Stenkelfled/B.cool/elektronik/bierkasten.brd

## EAGLE design elektronik/bierkasten.brd (2019-09-13)

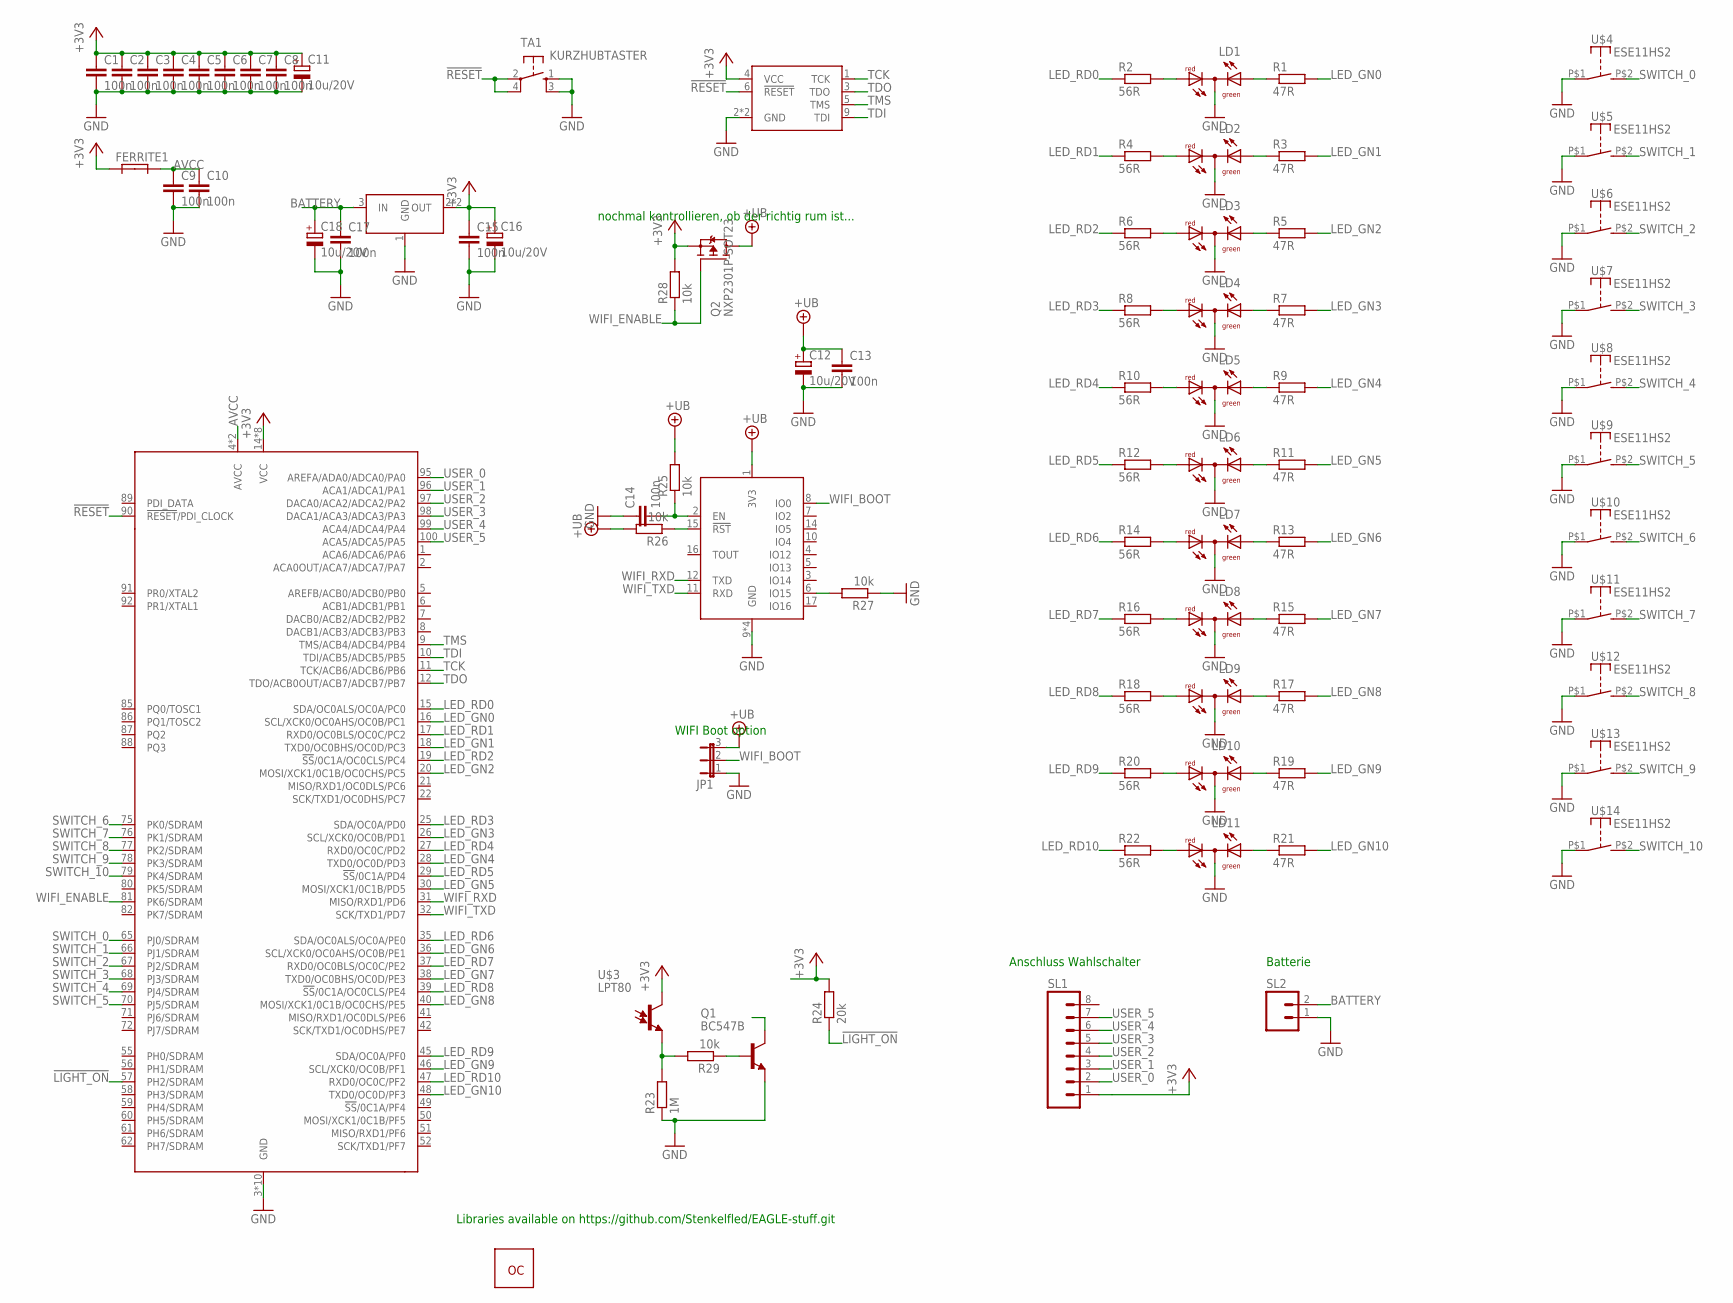
[picture p1: schematic bierkasten.sch]

Parts:
C1, C2, C3, C4, C5, C6, C7, C8, C9, C10, C13, C14, C15, C17: 100n; C0603; FARNELL 432210
C11, C12, C16, C18: 10u/20V; B/3528-21W
FERRITE1: FERRITE-EU_0805; L0805
JP1: JP2E; JP2
LD1, LD2, LD3, LD4, LD5, LD6, LD7, LD8, LD9, LD10, LD11: DUOLED-RG-C-WIRE; DUOLED-C-WIRE
Q1: BC547B; TO92
Q2: NXP2301P-SOT23; SOT23
R1, R3, R5, R7, R9, R11, R13, R15, R17, R19, R21: 47R; R0603; FARNELL 2502461
R2, R4, R6, R8, R10, R12, R14, R16, R18, R20, R22: 56R; R0603
R23: 1M; R0603
R24: 20k; R0603
R25, R26, R27, R28: 10k; R0603; FARNELL 2502397
R29: 10k; R0603
SL1: M08; 08P
SL2: M02; 02P
TA1: KURZHUBTASTER; TA93XX; FARNELL 2292960
U$1: ATXMEGA_A1; TQFP100
U$2: AVR-JTAG-10; WANNE10G
U$3: LPT80
U$4, U$5, U$6, U$7, U$8, U$9, U$10, U$11, U$12, U$13, U$14: ESE11HS2; 2X2,54
U$15: ESP8266-POLLIN
U$16: NCP1117ST33T3G; SOT223
U$17: BESTELLTEILE

Connections:
!LIGHT_ON: R24.1, U$1.57 (PH2/SDRAM)
!RESET: TA1.2, TA1.4 (P1), U$1.90 (!RESET!/PDI_CLOCK), U$2.6 (!RESET)
+3V3: C1.1, C2.1, C3.1, C4.1, C5.1, C6.1, C7.1, C8.1, C11.+, C15.1, C16.+, FERRITE1.1, Q2.2 (S), R24.2, R28.2, SL1.1, U$1.14 (VCC), U$1.24 (VCC), U$1.34 (VCC), U$1.44 (VCC), U$1.54 (VCC), U$1.64 (VCC), U$1.74 (VCC), U$1.83 (VCC), U$2.4 (VCC), U$3.C, U$16.2 (OUT), U$16.4 (OUT)
+UB: C12.+, C13.1, JP1.3, Q2.3 (D), R25.2, R26.2, U$15.1 (3V3)
AVCC: C9.1, C10.1, FERRITE1.2, U$1.4 (AVCC), U$1.94 (AVCC)
BATTERY: C17.1, C18.+, SL2.2, U$16.3 (IN)
GND: C1.2, C2.2, C3.2, C4.2, C5.2, C6.2, C7.2, C8.2, C9.2, C10.2, C11.-, C12.-, C13.2, C14.1, C15.2, C16.-, C17.2, C18.-, JP1.1, LD1.C, LD2.C, LD3.C, LD4.C, LD5.C, LD6.C, LD7.C, LD8.C, LD9.C, LD10.C, LD11.C, Q1.1 (E), R23.1, R27.1, SL2.1, TA1.1 (S), TA1.3 (S1), U$1.3 (GND), U$1.13 (GND), U$1.23 (GND), U$1.33 (GND), U$1.43 (GND), U$1.53 (GND), U$1.63 (GND), U$1.73 (GND), U$1.84 (GND), U$1.93 (GND), U$2.2 (GND), U$2.10 (GND), U$4.P$1, U$5.P$1, U$6.P$1, U$7.P$1, U$8.P$1, U$9.P$1, U$10.P$1, U$11.P$1, U$12.P$1, U$13.P$1, U$14.P$1, U$15.9 (GND), U$15.13 (GND), U$15.18 (GND), U$15.19 (GND), U$16.1 (GND)
LED_GN0: R1.2, U$1.16 (SCL/XCK0/OC0AHS/OC0B/PC1)
LED_GN1: R3.2, U$1.18 (TXD0/OC0BHS/OC0D/PC3)
LED_GN2: R5.2, U$1.20 (MOSI/XCK1/0C1B/OC0CHS/PC5)
LED_GN3: R7.2, U$1.26 (SCL/XCK0/OC0B/PD1)
LED_GN4: R9.2, U$1.28 (TXD0/OC0D/PD3)
LED_GN5: R11.2, U$1.30 (MOSI/XCK1/0C1B/PD5)
LED_GN6: R13.2, U$1.36 (SCL/XCK0/OC0AHS/OC0B/PE1)
LED_GN7: R15.2, U$1.38 (TXD0/OC0BHS/OC0D/PE3)
LED_GN8: R17.2, U$1.40 (MOSI/XCK1/0C1B/OC0CHS/PE5)
LED_GN9: R19.2, U$1.46 (SCL/XCK0/OC0B/PF1)
LED_GN10: R21.2, U$1.48 (TXD0/OC0D/PF3)
LED_RD0: R2.1, U$1.15 (SDA/OC0ALS/OC0A/PC0)
LED_RD1: R4.1, U$1.17 (RXD0/OC0BLS/OC0C/PC2)
LED_RD2: R6.1, U$1.19 (!SS!/0C1A/OC0CLS/PC4)
LED_RD3: R8.1, U$1.25 (SDA/OC0A/PD0)
LED_RD4: R10.1, U$1.27 (RXD0/OC0C/PD2)
LED_RD5: R12.1, U$1.29 (!SS!/0C1A/PD4)
LED_RD6: R14.1, U$1.35 (SDA/OC0ALS/OC0A/PE0)
LED_RD7: R16.1, U$1.37 (RXD0/OC0BLS/OC0C/PE2)
LED_RD8: R18.1, U$1.39 (!SS!/0C1A/OC0CLS/PE4)
LED_RD9: R20.1, U$1.45 (SDA/OC0A/PF0)
LED_RD10: R22.1, U$1.47 (RXD0/OC0C/PF2)
unnamed: LD1.AR, R2.2
unnamed: LD1.AX (AG), R1.1
unnamed: LD2.AR, R4.2
unnamed: LD2.AX (AG), R3.1
unnamed: LD3.AR, R6.2
unnamed: LD3.AX (AG), R5.1
unnamed: LD4.AR, R8.2
unnamed: LD4.AX (AG), R7.1
unnamed: LD5.AR, R10.2
unnamed: LD5.AX (AG), R9.1
unnamed: LD6.AR, R12.2
unnamed: LD6.AX (AG), R11.1
unnamed: LD7.AR, R14.2
unnamed: LD7.AX (AG), R13.1
unnamed: LD8.AR, R16.2
unnamed: LD8.AX (AG), R15.1
unnamed: LD9.AR, R18.2
unnamed: LD9.AX (AG), R17.1
unnamed: LD10.AR, R20.2
unnamed: LD10.AX (AG), R19.1
unnamed: LD11.AR, R22.2
unnamed: LD11.AX (AG), R21.1
unnamed: R23.2, R29.2, U$3.E
unnamed: C14.2, R25.1, U$15.2 (EN)
unnamed: R27.2, U$15.6 (IO15)
unnamed: R26.1, U$15.15 (!RST)
unnamed: Q1.2 (B), R29.1
SWITCH_0: U$1.65 (PJ0/SDRAM), U$4.P$2 (S)
SWITCH_1: U$1.66 (PJ1/SDRAM), U$5.P$2 (S)
SWITCH_2: U$1.67 (PJ2/SDRAM), U$6.P$2 (S)
SWITCH_3: U$1.68 (PJ3/SDRAM), U$7.P$2 (S)
SWITCH_4: U$1.69 (PJ4/SDRAM), U$8.P$2 (S)
SWITCH_5: U$1.70 (PJ5/SDRAM), U$9.P$2 (S)
SWITCH_6: U$1.75 (PK0/SDRAM), U$10.P$2 (S)
SWITCH_7: U$1.76 (PK1/SDRAM), U$11.P$2 (S)
SWITCH_8: U$1.77 (PK2/SDRAM), U$12.P$2 (S)
SWITCH_9: U$1.78 (PK3/SDRAM), U$13.P$2 (S)
SWITCH_10: U$1.79 (PK4/SDRAM), U$14.P$2 (S)
TCK: U$1.11 (TCK/ACB6/ADCB6/PB6), U$2.1 (TCK)
TDI: U$1.10 (TDI/ACB5/ADCB5/PB5), U$2.9 (TDI)
TDO: U$1.12 (TDO/ACB0OUT/ACB7/ADCB7/PB7), U$2.3 (TDO)
TMS: U$1.9 (TMS/ACB4/ADCB4/PB4), U$2.5 (TMS)
USER_0: SL1.2, U$1.95 (AREFA/ADA0/ADCA0/PA0)
USER_1: SL1.3, U$1.96 (ACA1/ADCA1/PA1)
USER_2: SL1.4, U$1.97 (DACA0/ACA2/ADCA2/PA2)
USER_3: SL1.5, U$1.98 (DACA1/ACA3/ADCA3/PA3)
USER_4: SL1.6, U$1.99 (ACA4/ADCA4/PA4)
USER_5: SL1.7, U$1.100 (ACA5/ADCA5/PA5)
WIFI_BOOT: JP1.2, U$15.8 (IO0)
WIFI_ENABLE: Q2.1 (G), R28.1, U$1.81 (PK6/SDRAM)
WIFI_RXD: U$1.31 (MISO/RXD1/PD6), U$15.12 (TXD)
WIFI_TXD: U$1.32 (SCK/TXD1/PD7), U$15.11 (RXD)

Notes on the sheet:
Libraries available on https://github.com/Stenkelfled/EAGLE-stuff.git
WIFI Boot option
Anschluss Wahlschalter
nochmal kontrollieren, ob der richtig rum ist...
Batterie

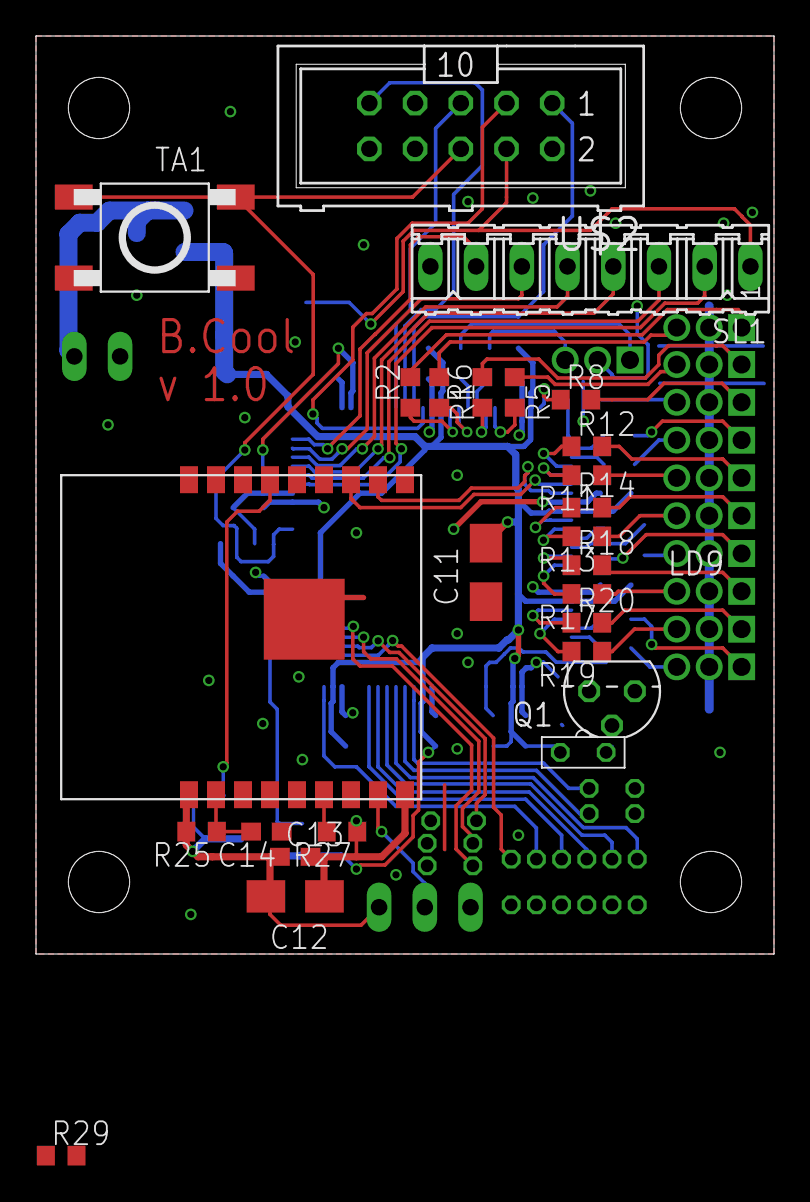
[picture p2: board bierkasten.brd from above]

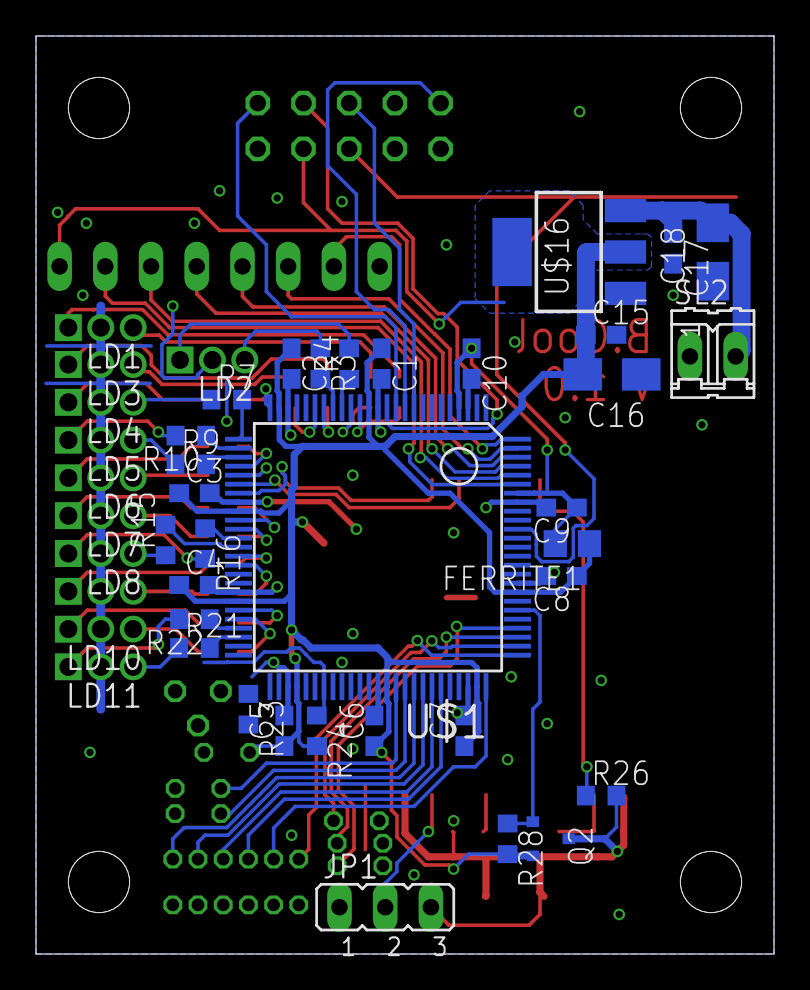
[picture p3: board bierkasten.brd from below]

Board: 2 copper layers, 41.0 x 51.0 mm, 82 parts (55 on the bottom side), 81 nets.
