Stenkelfled/B.cool/firmware/BeerSlot.cpp

/* 
* BeerSlot.cpp
*
* Created: 28.10.2018 11:48:47
* Author: stenkelfled
*/


#include "BeerSlot.h"

/**
 * @brief Creates a new Beer Slot.
 * For correct functionality, please initialize this slot after calling the constructor!
 * (functions setup(__), pinInit(__), ledInit(__)
 */
BeerSlot::BeerSlot()//BeerTimer * timer)
{
  this->sSwitch.state = eState::empty;
  this->user = USER_NOUSER;
} //BeerSlot

// default destructor
BeerSlot::~BeerSlot()
{
} //~BeerSlot

void BeerSlot::setup(BeerTimer * timer)
{
  this->timer = timer;
}

/**
 * @brief Initialize beer slot
 * @param switch_port The port-adress for the switch. Use e.g. &PORTA
 * @param switch_pin The pin number.
 */
void BeerSlot::pinInit(PORT_t * const switch_port, uint8_t const switch_pin)
{
  this->fill_time = (uint32_t)0;
  
  this->sSwitch.port = switch_port;
  this->sSwitch.pin = switch_pin;
    
  // init switch pin
  this->sSwitch.port->DIRCLR = (1<<this->sSwitch.pin);
  
  //Pullup and Interrupt on both edges
  *(&this->sSwitch.port->PIN0CTRL + this->sSwitch.pin) = PORT_OPC_PULLUP_gc | PORT_ISC_BOTHEDGES_gc;
    
  //set interrupts
  this->sSwitch.port->INTCTRL = PORT_INT0LVL_LO_gc;
  this->sSwitch.port->INT0MASK |= (1<<this->sSwitch.pin);

}

/**
 * @brief Set timer compare registers for LEDs
 * @param red Timer-Compare register for red LED
 * @param green Timer-Compare register for green LED
 */
void BeerSlot::ledInit(register16_t *red, register16_t *green)
{
  this->sLed.red = red;
  this->sLed.green = green;
  
  *this->sLed.red = 0;
  *this->sLed.green = 0;
}

/**
 * @brief Set BeerSlotLed-Color
 */
void BeerSlot::ledSetColor(BeerSlot::eLedColor const color)
{
  switch (color)
  {
    case eLedColor::Off:
      *this->sLed.red = 0;
      *this->sLed.green = 0;
      break;
    case eLedColor::Red:
      *this->sLed.red = LED_ON_VALUE;
      *this->sLed.green = 0;
      break;
    case eLedColor::Green:
      *this->sLed.red = 0;
      *this->sLed.green = LED_ON_VALUE;
      break;
    case eLedColor::Yellow:
      *this->sLed.red = LED_ON_VALUE;
      *this->sLed.green = LED_ON_VALUE;
      break;
  }
}

void BeerSlot::update(user_t user_state)
{
  eState const new_state = (this->sSwitch.port->IN & (1<<this->sSwitch.pin))?eState::empty:eState::full; //pin is LOW-active
  if(this->sSwitch.state != new_state)
  {
    this->sSwitch.state = new_state;
    if(this->sSwitch.state == eState::full)
    {
      this->fill_time = this->timer->getTime();
      this->user = user_state;
    }
    else
    {
      this->user = USER_NOUSER;
    }
  }
  
  //update LED
  if( (this->sSwitch.state == eState::empty)
    ||(user_state != this->user)
    )
  {
    ledSetColor(eLedColor::Off);
  }
  else
  {
    BeerTime time_diff = this->timer->getTime() - this->fill_time;
    if(time_diff >= BEER_TIME_GREEN)
    {
      ledSetColor(eLedColor::Green);
    }
    else if(time_diff >= BEER_TIME_YELLOW)
    {
      ledSetColor(eLedColor::Yellow);
    }
    else
    {
      ledSetColor(eLedColor::Red);
    }
  }
}
