Stenkelfled/B.cool/firmware/RingBuffer.cpp

/* 
* RingBuffer.cpp
*
* Created: 10.03.2019 16:35:37
* Author: stenkelfled
*/


#include "RingBuffer.h"
/*
// default constructor
RingBuffer::RingBuffer()
{
} //RingBuffer

// default destructor
RingBuffer::~RingBuffer()
{
} //~RingBuffer
*/
