Stenkelfled/B.cool/(commit log)

2018-08-17 Anfänge des Schaltplans
    [bierkasten.brd, bierkasten.sch]
2018-08-17 Bestellcodes fertig gemacht
    [bierkasten.brd, bierkasten.sch]
2018-08-19 Stecker für User-Wahlschalter hinzugefügt.
    [bierkasten.brd, bierkasten.sch]
2018-09-08 Schaltplan fertig
    [bierkasten.brd, bierkasten.sch]
2018-09-28 Layout fertig
    [bierkasten.brd, bierkasten.sch]
2018-09-28 Fertigungsdaten erstellt
    [bierkasten.brd, bierkasten.sch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]
2018-09-28 Ärger mit den Bordaten behoben. PCB bestellt.
    [bierkasten.brd, bierkasten.sch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]
2018-11-04 Initialization for Beer LED-Timers
2018-11-10 Add LED color definition
2018-11-18 Add LED initialization
2018-12-23 WIP: add RTC-timer
2019-01-01 Add Power management
2019-01-01 Set LED color by time
2019-01-27 First test: successful
    * LED goes green, when bottle is inserted and off, when bottle is
    removed
    * No timing via RTC, no sleeping, but LEDs are controlled via Timer and
    PWM
2019-01-27 LEDs now light in the proper color
    * However, Updating the LEDs is still a problem.
    [BeerSlot.cpp, BeerTimer.cpp, BeerTimer.h, b_cool.h, main.cpp]
2019-01-29 Preparetion for sleep: Light detection now working
    * Plus: The LED-Updates now takes place in main - not in interrupt
2019-01-29 Add User switch
2019-09-13 Light detection has its own PCB
    [bierkasten.brd, bierkasten.sch]
2019-09-13 Adjust LED brightness
